PIULAB/DANDY/README.md

Dandy, Personal Robotic Arm Controlled by joystick

Created by +Lab Team

Servos used:
Dynamixel MX64
Dynamixel MX28

Controller used:
Arduino Mega 2560
Personal Computer
