PIULAB/DANDY/openrave/dandy/STEP_ROBOTIC_ARM/assieme_forcelle_asm.stp

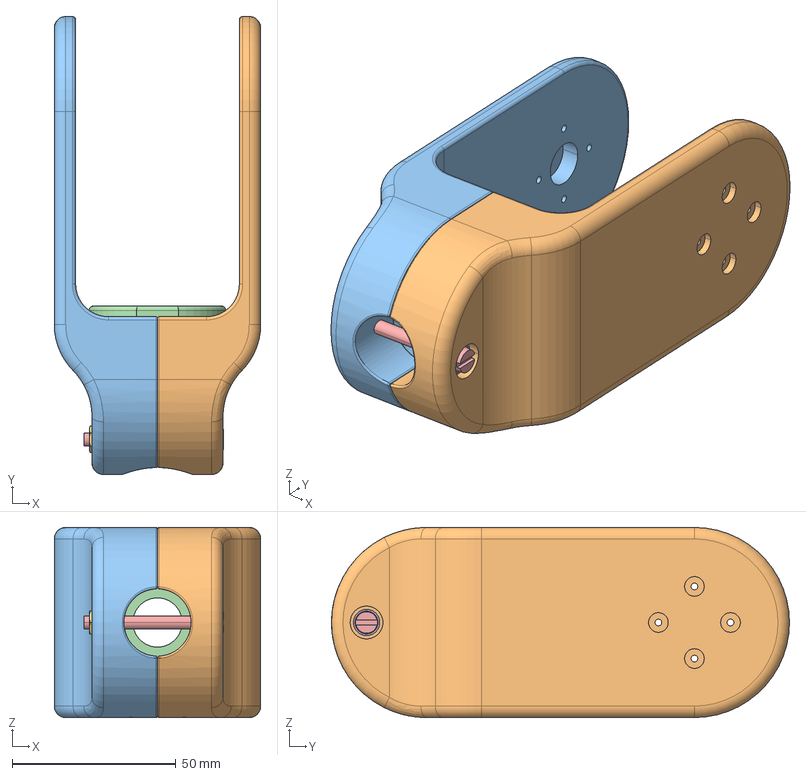
[picture p1: CAD file, 2016-11-24]
openrave/dandy/STEP_ROBOTIC_ARM/assieme_forcelle_asm.stp
63.0 x 139.7 x 58.0 mm
FORCELLA1
FORCELLA2
GUARNIZIONE_FORCELLE
ISLGS0111
IWPSA06 x 2
INHS105
