PIULAB/DANDY/openrave/dandy/STEP_ROBOTIC_ARM/assieme_basculante_asm.stp

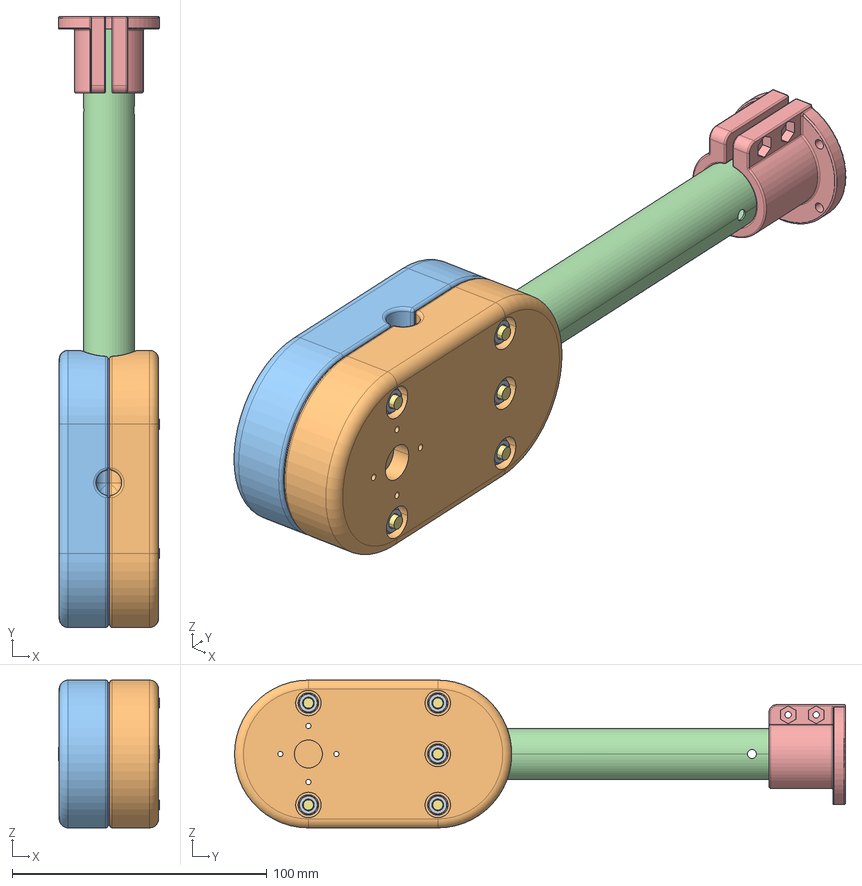
[picture p2: CAD file, 2016-11-24]
openrave/dandy/STEP_ROBOTIC_ARM/assieme_basculante_asm.stp
39.8 x 239.8 x 58.0 mm
BASCULANTE
BASCULANTE_SPECCHIO
TUBO1
MANICOTTO
GUARNIZIONE_BASCULANTE
ISLPS0510 x 5
IWPSA06 x 10
INHS105 x 5
