PIULAB/DANDY/openrave/dandy/STEP_ROBOTIC_ARM/guscio_gomito_asm.stp

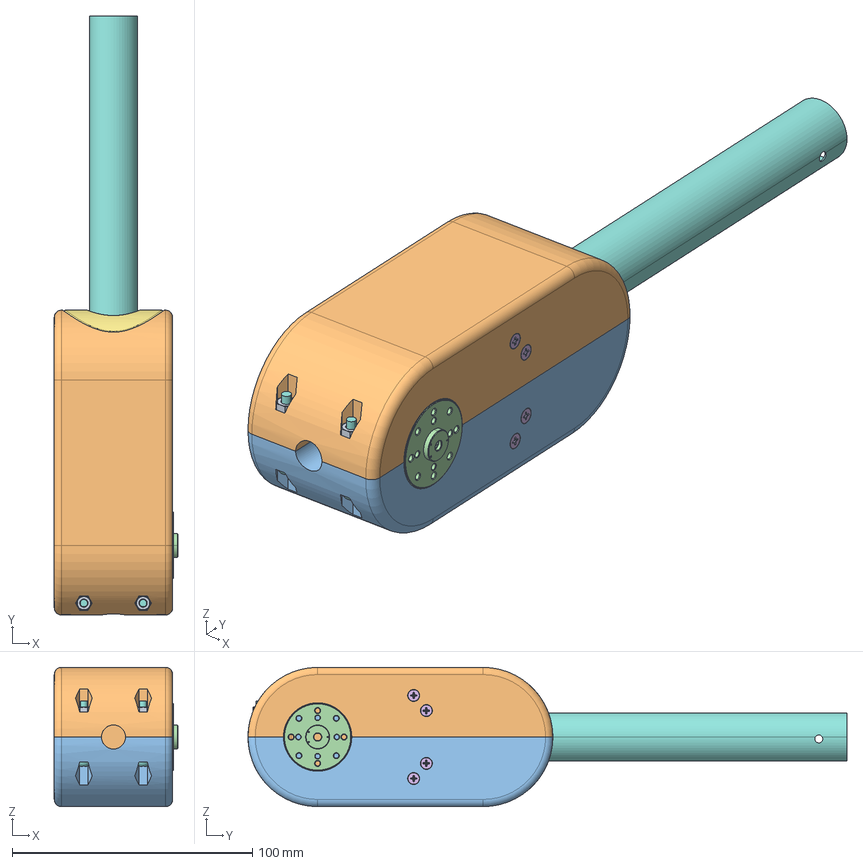
[picture p3: CAD file, 2016-11-24]
openrave/dandy/STEP_ROBOTIC_ARM/guscio_gomito_asm.stp
51.5 x 249.5 x 58.0 mm
GUSCIO_MX64_GOMITO_DX
GUSCIO_GOMITO_SPECCHIO
MANICOTTO
GUARNIZIONE_GOMITO_2
GUARNIZIONE_GOMITO
COPRIMANICOTTO
TUBOLARE2
TRUSTER
MX-64T_
1226T
HN05_N102
HN05-I101
ICRFS0208 x 8
INHS103 x 8
ICRPS0409 x 2
INHS104 x 4
ISLPS0406 x 2
IWPNA04 x 4
