PIULAB/DANDY/triangles-map.py

import json
import serial
from inclusion import *
import time

SPOT = 60
DIAGONAL_SPOT = 0
CENTER = 512

maps = [
  [(0,0+DIAGONAL_SPOT), (0,1024-DIAGONAL_SPOT), (CENTER-SPOT,CENTER+SPOT), (CENTER-SPOT,CENTER-SPOT)],
  [(0+DIAGONAL_SPOT,1024), (1024-DIAGONAL_SPOT,1024), (CENTER+SPOT,CENTER+SPOT), (CENTER-SPOT,CENTER+SPOT)],
  [(1024,1024-DIAGONAL_SPOT), (1024,0+DIAGONAL_SPOT), (CENTER+SPOT,CENTER-SPOT), (CENTER+SPOT,CENTER+SPOT)],
  [(1024-DIAGONAL_SPOT,0), (0+DIAGONAL_SPOT,0), (CENTER-SPOT,CENTER-SPOT), (CENTER+SPOT,CENTER-SPOT)]
]
lines = {
  0: [(CENTER,CENTER), (0,CENTER)],
  1: [(CENTER,CENTER), (CENTER,1024)],
  2: [(CENTER,CENTER), (1024,CENTER)],
  3: [(CENTER,CENTER), (CENTER,0)]
}

ser = serial.Serial('/dev/ttyACM0', 115200)
time.sleep(2)

def main():
  count = 0
  t0 = 0

  while True:
    s = ser.readline()
    try:
      payload = json.loads(s)

      # discard too fast joystick positions
      if payload.has_key('x') and time.time() - t0 < 0.1:
        continue
      t0 = time.time()

      if payload.has_key('x') and payload.has_key('y'):
        analyze_position(payload)
      else:
        # None
        print payload

    except ValueError:
      count += 1
      if count % 10 == 0:
        # None
        print '10 garbage received'


def analyze_position(payload):
  P0 = (payload['x'], payload['y'])

  zone = 4
  for i in range(len(maps)):
    if in_polygon(P0, maps[i]):
      zone = i
      break

  if zone >= 4:
    ser.write('speed_A:1\n')
    ser.write('speed_B:1\n')
    ser.write('speed_C:1\n')
    ser.write('speed_D:1\n')
  else:
    speed = point_to_line(P0, lines[zone][0], lines[zone][1])
    direction = is_left(P0, lines[zone][0], lines[zone][1]) < 0
    if zone >= 2:
      direction = not direction

    suffix = {0:'_A', 1:'_B', 2:'_C', 3:'_D'}[zone]
    ser.write('speed%(suffix)s:%(speed)s\n' % {'suffix': suffix, 'speed': int(round(speed/4))+1})
    ser.write('direction%(suffix)s:%(direction)s\n' % {'suffix': suffix, 'direction': {False: 'CCW', True: 'CW'}[direction]})

    print P0, ['A', 'B', 'C', 'D'][zone], speed, {True: 'forward', False: 'backward'}[direction]

if __name__ == "__main__":
  main()
