PIULAB/DANDY/(commit log)

2016-11-04 speed/direction to motor
2016-11-07 demo 7 nov - 4 motors ok (more or less)
2016-11-22 initial import of openrave files
    [dandy.robot.xml]
2016-11-24 generation 2 works
    [assieme_basculante_asm.stp, assieme_forcelle_asm.stp, assieme_spalla_asm.stp, dandy.robot.xml, guscio_gomito_asm.stp, snodo1_asm.stp, snodo_2_asm.stp]
2016-12-01 ongoing test of all motors
2016-12-05 all motors ok, added library for MX-12
2016-12-14 better arm model, joypad gen 2, test of slow start
    [dandy.robot.xml]
2017-02-24 Edited for publication
    [assieme_spalla_asm.stp, snodo1_asm.stp, snodo_2_asm.stp]
